tabo1337/Mini-Sumo-Project/(list of files, drawings)

Other design files:
PCB/SONKART.pdsprj
